planta223/2026ESWContest_free_GONGDI/doc/ESP32_GPIO_Pinout.xlsx

기능 | ESP32 GPIO
MAX7219 DIN | GPIO23
MAX7219 CLK | GPIO18
MAX7219 CS | GPIO27
DFPlayer RX ← ESP32 TX | GPIO17
DFPlayer TX → ESP32 RX | GPIO16
ULN2003 IN1 | GPIO25
ULN2003 IN2 | GPIO26
ULN2003 IN3 | GPIO32
ULN2003 IN4 | GPIO33
진동모터 제어 | GPIO14
버튼 | GPIO21
버튼 LED | GPIO22
