planta223/2026ESWContest_free_GONGDI/THIRD_PARTY_NOTICES.md

# Third-party notices

## Dalmoori Font

The 15 Hangul glyph bitmaps embedded in `matrix_display.cpp` are adapted from
Dalmoori Font v0.200.

- Project: https://github.com/RanolP/dalmoori-font
- Author: RanolP and contributors
- License: Apache License 2.0
- Changes: Only the 15 syllables required by 점잡이 were extracted as 8x8
  monochrome row bitmaps and stored in firmware order.

The corresponding license text is included at `LICENSES/Apache-2.0.txt`.
