planta223/2026ESWContest_free_GONGDI/doc/DFPlayer_Mini_Pinout.png

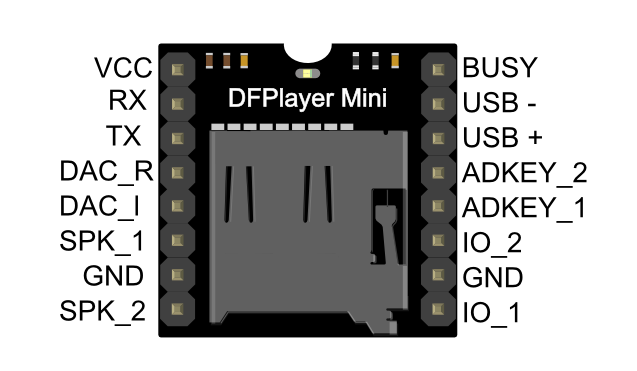
doc/DFPlayer_Mini_Pinout.png
