planta223/2026ESWContest_free_GONGDI/doc/진동모터결선.png

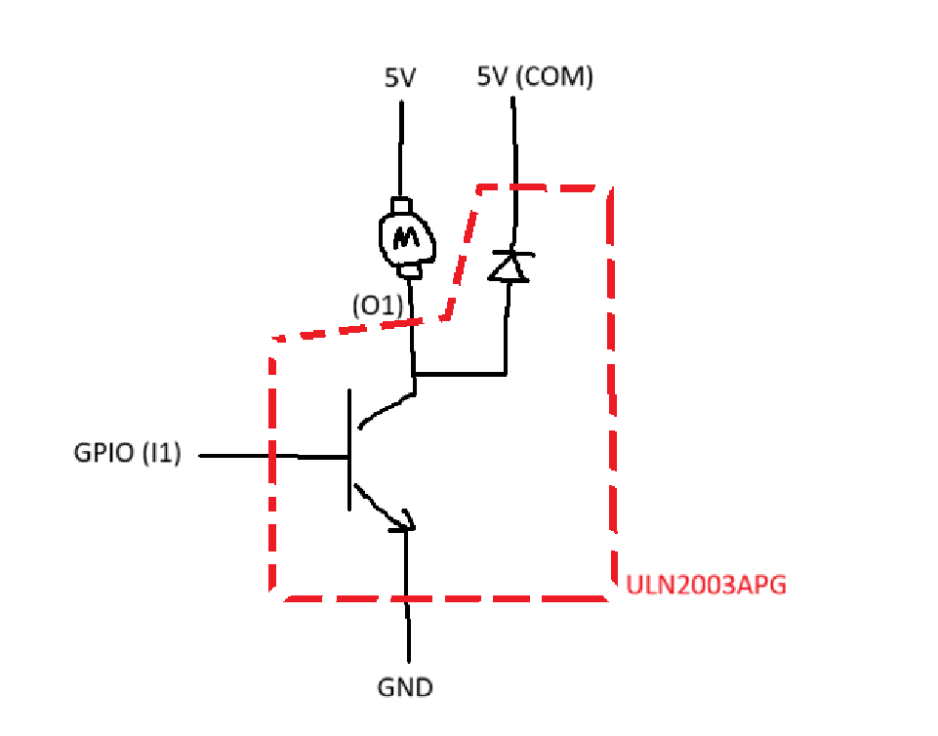
doc/진동모터결선.png
