planta223/2026ESWContest_free_GONGDI/matrix_display.cpp

#include "matrix_display.h"

#include <MD_MAX72xx.h>

#include "config.h"

namespace {

// Each glyph is eight rows, MSB at the left. These 15 precomposed Hangul
// bitmaps are adapted from Dalmoori, an 8x8 pixel Hangul font designed for
// legibility at this exact resolution (Apache-2.0; see THIRD_PARTY_NOTICES.md).
// Keeping only the required glyphs avoids UTF-8 parsing and a full font table.
const uint8_t GLYPH_ROWS[static_cast<uint8_t>(GlyphId::COUNT)][8] PROGMEM = {
    // 동
    {0b01111100, 0b01000000, 0b01111100, 0b00010000,
     0b11111110, 0b00111000, 0b01000100, 0b00111000},
    // 대
    {0b11110101, 0b10000101, 0b10000101, 0b10000111,
     0b10000101, 0b11110101, 0b00000101, 0b00000101},
    // 문
    {0b01111100, 0b01000100, 0b01111100, 0b11111110,
     0b00010000, 0b01000000, 0b01000000, 0b01111100},
    // 역
    {0b01110110, 0b10001010, 0b10001110, 0b01110010,
     0b00000000, 0b01111110, 0b00000010, 0b00000010},
    // 사
    {0b00100010, 0b00100010, 0b00100010, 0b01010011,
     0b01010010, 0b10001010, 0b00000010, 0b00000010},
    // 공
    {0b01111100, 0b00000100, 0b00010100, 0b11111110,
     0b00000000, 0b00111000, 0b01000100, 0b00111000},
    // 원
    {0b01110010, 0b10001010, 0b01110010, 0b11111010,
     0b00100110, 0b01000000, 0b01000000, 0b01111110},
    // 신
    {0b00100010, 0b00100010, 0b01010010, 0b10001010,
     0b00000000, 0b01000000, 0b01000000, 0b01111110},
    // 당
    {0b11111010, 0b10000011, 0b10000010, 0b11111010,
     0b00000000, 0b00111100, 0b01000010, 0b00111100},
    // 상
    {0b00100010, 0b00100011, 0b01010010, 0b10001010,
     0b00000000, 0b00111100, 0b01000010, 0b00111100},
    // 왕
    {0b01110010, 0b10001010, 0b01110011, 0b00100010,
     0b11111010, 0b00111100, 0b01000010, 0b00111100},
    // 십
    {0b00100010, 0b00100010, 0b01010010, 0b10001010,
     0b01000010, 0b01111110, 0b01000010, 0b01111110},
    // 리
    {0b11111010, 0b00001010, 0b11111010, 0b10000010,
     0b10000010, 0b11111010, 0b00000010, 0b00000010},
    // 한
    {0b01110010, 0b11111011, 0b01010010, 0b00100010,
     0b00000000, 0b01000000, 0b01000000, 0b01111110},
    // 양
    {0b01110011, 0b10001010, 0b10001011, 0b01110010,
     0b00000000, 0b00111100, 0b01000010, 0b00111100},
};

constexpr uint8_t GLYPH_WIDTH = 8;
constexpr size_t GLYPH_SPACING_COLUMNS =
    static_cast<size_t>(MATRIX_GLYPH_SPACING_CELLS);
constexpr size_t MAX_CONTENT_COLUMNS =
    static_cast<size_t>(MAX_STATION_GLYPHS) * GLYPH_WIDTH
    + static_cast<size_t>(MAX_STATION_GLYPHS - 1) * GLYPH_SPACING_COLUMNS;

static_assert(MAX_CONTENT_COLUMNS <= INT32_MAX,
              "Matrix text width must fit the signed scroll coordinate");

MD_MAX72XX matrix(
    MATRIX_HARDWARE_TYPE,
    PIN_MATRIX_DIN,
    PIN_MATRIX_CLK,
    PIN_MATRIX_CS,
    MATRIX_DEVICE_COUNT);

enum class DisplayMode : uint8_t { IDLE, STATIC, SCROLLING };

DisplayMode mode = DisplayMode::IDLE;
const StationInfo* scrollingStation = nullptr;
size_t contentWidth = 0;
int32_t scrollOffset = 0;
uint32_t lastFrameAt = 0;

uint8_t glyphColumn(GlyphId glyph, uint8_t x) {
  const uint8_t glyphIndex = static_cast<uint8_t>(glyph);
  if (glyphIndex >= static_cast<uint8_t>(GlyphId::COUNT) || x >= GLYPH_WIDTH) {
    return 0;
  }

  uint8_t column = 0;

  if (MATRIX_ROTATE_GLYPHS_CCW) {
    // For a counter-clockwise rotation, destination column x is source row x.
    // Source MSB (left pixel) becomes destination bit 7 (bottom pixel), so the
    // stored row byte is already the correctly rotated output column.
    column = pgm_read_byte(&GLYPH_ROWS[glyphIndex][x]);
  } else {
    const uint8_t rowMask = static_cast<uint8_t>(0x80U >> x);
    for (uint8_t row = 0; row < MATRIX_HEIGHT; ++row) {
      const uint8_t rowBits = pgm_read_byte(&GLYPH_ROWS[glyphIndex][row]);
      if ((rowBits & rowMask) != 0) {
        column |= static_cast<uint8_t>(1U << row);
      }
    }
  }

  if (MATRIX_FLIP_VERTICAL) {
    uint8_t reversed = 0;
    for (uint8_t bit = 0; bit < MATRIX_HEIGHT; ++bit) {
      if ((column & static_cast<uint8_t>(1U << bit)) != 0) {
        reversed |= static_cast<uint8_t>(1U << (MATRIX_HEIGHT - 1 - bit));
      }
    }
    column = reversed;
  }

  return column;
}

size_t textWidth(const StationInfo& info) {
  if (info.glyphCount == 0) {
    return 0;
  }
  return static_cast<size_t>(info.glyphCount) * GLYPH_WIDTH
         + static_cast<size_t>(info.glyphCount - 1) * GLYPH_SPACING_COLUMNS;
}

uint8_t textColumn(const StationInfo& info, size_t textX) {
  const size_t glyphStride = GLYPH_WIDTH + GLYPH_SPACING_COLUMNS;
  const size_t glyphIndex = textX / glyphStride;
  const size_t columnInStride = textX % glyphStride;
  if (glyphIndex >= info.glyphCount || columnInStride >= GLYPH_WIDTH) {
    return 0;
  }
  return glyphColumn(info.glyphs[glyphIndex], static_cast<uint8_t>(columnInStride));
}

void writePhysicalColumn(uint8_t logicalColumn, uint8_t value) {
  if (logicalColumn >= MATRIX_WIDTH) {
    return;
  }
  const uint8_t physicalColumn = MATRIX_REVERSE_COLUMNS
                                     ? (MATRIX_WIDTH - 1 - logicalColumn)
                                     : logicalColumn;
  matrix.setColumn(physicalColumn, value);
}

void beginFrame() {
  matrix.control(MD_MAX72XX::UPDATE, MD_MAX72XX::OFF);
}

void endFrame() {
  matrix.control(MD_MAX72XX::UPDATE, MD_MAX72XX::ON);
}

void renderStatic(const StationInfo& info, size_t width) {
  const size_t leftPadding = width < MATRIX_WIDTH ? (MATRIX_WIDTH - width) / 2 : 0;

  beginFrame();
  for (uint8_t screenX = 0; screenX < MATRIX_WIDTH; ++screenX) {
    uint8_t value = 0;
    if (screenX >= leftPadding && screenX < leftPadding + width) {
      value = textColumn(info, static_cast<size_t>(screenX) - leftPadding);
    }
    writePhysicalColumn(screenX, value);
  }
  endFrame();
}

void renderScrollFrame() {
  beginFrame();
  for (uint8_t screenX = 0; screenX < MATRIX_WIDTH; ++screenX) {
    const int32_t sourceX = scrollOffset + screenX;
    const uint8_t value = scrollingStation != nullptr
                                  && sourceX >= 0
                                  && static_cast<size_t>(sourceX) < contentWidth
                              ? textColumn(*scrollingStation, static_cast<size_t>(sourceX))
                              : 0;
    writePhysicalColumn(screenX, value);
  }
  endFrame();
}

}  // namespace

void matrixBegin() {
  matrix.begin();
  matrix.control(MD_MAX72XX::INTENSITY, MATRIX_INTENSITY);
  matrix.clear();

#if DEBUG_MATRIX
  Serial.printf("[MATRIX] Ready: %ux%u, devices: %u\n",
                MATRIX_WIDTH, MATRIX_HEIGHT, MATRIX_DEVICE_COUNT);
#endif
}

void matrixShowStation(StationId station) {
  const StationInfo* info = getStationInfo(station);
  if (info == nullptr || info->glyphCount == 0 || info->glyphCount > MAX_STATION_GLYPHS) {
#if DEBUG_MATRIX
    Serial.println(F("[MATRIX] Invalid station glyph data"));
#endif
    return;
  }

#if DEBUG_MATRIX
  Serial.printf("[MATRIX] Display: %s (%s)\n", info->name, info->debugName);
#endif

  const size_t width = textWidth(*info);
  if (width <= MATRIX_WIDTH) {
    scrollingStation = nullptr;
    contentWidth = width;
    renderStatic(*info, width);
    mode = DisplayMode::STATIC;
    return;
  }

  // Columns are generated from the glyph table on demand, so larger spacing
  // values do not require a proportionally larger RAM buffer.
  scrollingStation = info;
  contentWidth = width;
  scrollOffset = -static_cast<int32_t>(MATRIX_WIDTH);
  lastFrameAt = millis();
  mode = DisplayMode::SCROLLING;
  renderScrollFrame();
}

void matrixUpdate() {
  const uint32_t now = millis();

  if (mode == DisplayMode::STATIC) {
    // Keep the current station visible until another station replaces it.
    return;
  }

  if (mode != DisplayMode::SCROLLING
      || static_cast<uint32_t>(now - lastFrameAt) < MATRIX_SCROLL_INTERVAL_MS) {
    return;
  }

  lastFrameAt = now;
  ++scrollOffset;
  renderScrollFrame();

  // source offset == contentWidth is the first completely blank exit frame.
  if (scrollOffset >= static_cast<int32_t>(contentWidth)) {
    // Long station names repeat forever so the matrix never becomes idle.
    scrollOffset = -static_cast<int32_t>(MATRIX_WIDTH);
#if DEBUG_MATRIX
    Serial.println(F("[MATRIX] Scroll repeat"));
#endif
  }
}

void matrixClear() {
  matrix.clear();
  scrollingStation = nullptr;
  contentWidth = 0;
  mode = DisplayMode::IDLE;
}

bool matrixIsActive() {
  return mode != DisplayMode::IDLE;
}
