planta223/2026ESWContest_free_GONGDI/(commit log)

2026-08-20 초안 작성
    [partitions.csv]
2026-08-20 document 추가
    [ESP32_GPIO_Pinout.xlsx]
2026-08-20 도트매트릭스 글자 깨짐 수정 (이후 방향 수정 필요)
    [config.h, matrix_display.cpp]
2026-08-21 mp3 파일 변경
2026-08-21 도트매트릭스 반시계방향 90도 회전 수정
    [config.h, matrix_display.cpp]
2026-08-29 api, wifi 통합
2026-08-29 도트매트릭스 자간간격 옵션구현 및 wifi,serial 정상 테스트
2026-08-30 수정 (자세한 사항 모름)
    [api.cpp, api.h, config.h, esp32_braille.ino, station_data.cpp]
2026-08-31 도트매트릭스/스텝모터 auto, 진동/음성 manual 변경. 역사 전환시 스텝모터 거리간격 수동 튜닝 완료.
2026-09-02 build, legacy 폴더 삭제
    [partitions.csv]
2026-09-02 arrivetime 아닌 lefttime 사용하도록 변경
2026-09-02 초기 동대문역사공원 고정, 출발역사 별 lefttime delay 설정 추가
2026-09-02 버튼이 도트매트릭스 애니메이션에 영향주지 않도록 수정
    [esp32_braille.ino]
2026-09-02 ui에 지하철 애니메이션 추가
2026-09-02 REALTIME api 추가
2026-09-02 직전 커밋 버그 수정 (테스트 필요)
    [api.cpp]
2026-09-02 ui 수정 (reboot, log, auto_api_calling) (realtime interval ms 수정 필요)
    [api.cpp, api.h, config.h, debug_log.cpp, debug_log.h, wifi_manager.cpp]
2026-09-02 api 로직 수정
2026-09-02 polling 간격 짧게, 애니메이션 수정
    [config.h]
2026-09-02 최종 정상 시연 완료
2026-09-02 DotJabi -> 점잡이 용어 변경
2026-09-02 README 수정
